TheAfricanJiant/epod/mobile/stitch_elite_interface_design (1)/stitch_elite_interface_design/device_status/code.html

settings_input_component

# e-Pod

sensors

## System Diagnostics

HW_REV_3.2 | MASTER_OF_RECYCLING

### BATTERY_HEALTH

80%

Donor: Modem X1

### sd_storage STORAGE_ALLOCATION

14.2 GB / 32 GB

Used

Free

### TELEMETRY_LOG

LIVE

[SYS] Init Sequence Complete 00:00:01

[NET] RSSI: -65dBm (Good) 00:00:04

[NET] MTU Size negotiated: 1500 00:00:05

[HW] Mic Array (ReSpeaker Lite) Ready 00:00:08

[SYS] Storage mount /dev/mmcblk0p1 OK 00:00:12

[WARN] Temp sensor 2 anomaly detected 00:00:15

[SYS] Awaiting command... 00:00:16

### VOICE_INPUT (ReSpeaker Lite)

Harvested 2-mic array for voice commands and localized processing.

mic Voice Control

### description LOCAL_VOICE_NOTES

- play_circle
  Idea_01.wav
  1.2 MB | 02:14
  delete
- play_circle
  Meeting_Notes.wav
  4.5 MB | 08:30
  delete

qr_code_scanner
