TheAfricanJiant/epod/mobile/stitch_elite_interface_design (1)/stitch_elite_interface_design/device_status_dark_soft/code.html

settings_input_antenna

# AudioPure

battery_charging_full

## Device Status

Real-time diagnostics and environmental telemetry for e-Pod unit alpha-7.

bolt

### Power Core

Healthy

80 %

Donor Module Tesla Mod-3 Cell

memory

### Storage

14.2 GB Used of 64 GB

Audio Data

System OS

Cache

record_voice_over

### Voice Interface

Wake Word "Hey e-Pod" activation

Continuous Listen Contextual follow-up mode

terminal

### Live Telemetry

Export Log

14:02:41.03 [SYS] Acoustic array initialized. 8/8 mics online.

14:02:41.15 [SYS] Thermal threshold nominal at 32°C.

14:02:42.88 [NET] Syncing metadata block xA92F... OK.

14:03:05.12 [BATT] Draw spike detected: 1.2A. Resuming normal envelope.

14:03:10.00 [SYS] Awaiting command stream...

14:03:10.01
