TheAfricanJiant/epod/mobile/stitch_elite_interface_design (1)/stitch_elite_interface_design/android_studio_template_guidance.md

# **Comprehensive Evaluation of Android Studio Project Templates and Development Specification for the e-Pod Companion Application**

## **Architectural Context and System Requirements**

The e-Pod zero-waste wireless audio player requires a companion Android mobile application to serve as an out-of-band management interface and binary file streaming client1. Operating within a 28-day build window, the system links a mobile handheld device directly to an ESP32-S3 microcontroller core (ReSpeaker Lite) integrated with an SPI MicroSD card module, an SSD1306 OLED display, an onboard 5W Class-D amplifier, and a salvaged laptop speaker1. Rather than utilizing traditional physical media connectors or cloud-mediated APIs, the system relies exclusively on Bluetooth Low Energy (BLE 5.0) for remote telemetry mirroring, media playback control, and chunked binary file transfer1.

\+---------------------------------------------------------------------------------------+  
|                                    Android Mobile App                                 |  
|                                                                                       |  
|  \+---------------------------------------------------------------------------------+  |  
|  |                           Presentation Layer (Compose UI)                       |  |  
|  |   \[Scan Screen\]    \[Now Playing Remote\]    \[File Transfer\]    \[Device Status\]   |  |  
|  \+---------------------------------------------------------------------------------+  |  
|                                          ^                                            |  
|                                          | (StateFlow / UI Events)                    |  
|                                          v                                            |  
|  \+---------------------------------------------------------------------------------+  |  
|  |                            Domain Layer (ViewModels)                            |  |  
|  \+---------------------------------------------------------------------------------+  |  
|                                          ^                                            |  
|                                          | (Suspend Functions / Flow)                 |  
|                                          v                                            |  
|  \+---------------------------------------------------------------------------------+  |  
|  |            BLE Transport Layer (Nordic Android-BLE-Library / ble-ktx)           |  |  
|  \+---------------------------------------------------------------------------------+  |  
\+------------------------------------------|--------------------------------------------+  
                                           |  
                                           | (BLE 5.0 GATT / MTU 517 Chunks)  
                                           v  
\+---------------------------------------------------------------------------------------+  
|                                  e-Pod Hardware Player                                |  
|                                                                                       |  
|  \+---------------------------------------------------------------------------------+  |  
|  |                  Core MCU: ReSpeaker Lite (XIAO ESP32-S3)                       |  |  
|  |                                                                                 |  |  
|  |   \+-------------------+     \+--------------------+     \+--------------------+   |  |  
|  |   | SPI MicroSD Card  |     | Onboard 5W Amp     |     | I2C SSD1306 OLED   |   |  |  
|  |   | (Audio Storage)   |     | & Laptop Speaker   |     | (Display UI)       |   |  |  
|  |   \+-------------------+     \+--------------------+     \+--------------------+   |  |  
|  \+---------------------------------------------------------------------------------+  |  
\+---------------------------------------------------------------------------------------+

Developing this application requires leveraging an AI pair-programming environment such as Antigravity1. Selecting an appropriate baseline template within Android Studio is essential to minimize architectural debt, eliminate unnecessary user interface boilerplate, and facilitate code generation1. The mobile client must implement Nordic Semiconductor’s Android-BLE-Library (specifically the modern ble-ktx coroutines module) to abstract Android’s native asynchronous Bluetooth Low Energy callbacks into reactive streams1.

## **Comparative Analysis of Android Studio Project Templates**

Modern Android Studio releases provide several starter templates designed for different application paradigms. Evaluating these templates against the operational requirements of the e-Pod client reveals significant trade-offs in structural complexity, UI framework alignment, and compatibility with AI-assisted code generation platforms1.

| Android Studio Template | UI Framework Architecture | Baseline Code Overhead | Suitability for e-Pod | Strategic Rationale and Technical Assessment |
| :---- | :---- | :---- | :---- | :---- |
| **Empty Activity** | Jetpack Compose (Material 3\) | Minimal | **Optimal (Recommended)** | Generates a clean, modern single-activity architecture configured for Jetpack Compose and ComponentActivity1. Eliminates legacy XML layouts, simplifying AI code generation while aligning natively with Kotlin StateFlow streams1. |
| **No Activity** | None (Raw Project Structure) | Zero UI Baseline | **High (Alternative)** | Configures Gradle scripts, dependency targets, and the manifest without generating UI components. Requires the AI workspace to construct the directory layout, DI modules, and activities from scratch. |
| **Empty Views Activity** | Legacy XML ViewBinding | Moderate | **Sub-optimal** | Configures legacy XML view hierarchies, ViewBinding classes, and AppCompatActivity. Adds layout boilerplate that increases friction when binding asynchronous BLE state streams1. |
| **Bottom Navigation Views Activity** | Legacy XML Views & Fragments | High | **Not Recommended** | Pre-configures a multi-fragment architecture using BottomNavigationView and NavController tied to XML resource graphs. Overcomplicates state synchronization across BLE connection lifecycles1. |
| **Navigation Drawer Views Activity** | Legacy XML Views & Drawer | High | **Not Recommended** | Designed for complex multi-tier enterprise applications utilizing drawer layouts. The e-Pod application requires a focused four-screen dashboard where persistent side drawers are redundant1. |
| **Native C++** | Android NDK / C++ CMake | Extremely High | **Unnecessary** | Configures CMake toolchains and Java Native Interface (JNI) stubs. Because hardware operations are executed on the ESP32-S3 microcontroller, native C++ compilation on the mobile client is redundant1. |

The evaluation demonstrates that the **Empty Activity** (Jetpack Compose) template represents the definitive structural foundation for the e-Pod mobile application1. Declarative UI frameworks natively observe asynchronous data streams emitted by Kotlin StateFlow primitives without requiring explicit view invalidation or adapter binding code2. Pre-configured templates utilizing XML layouts introduce legacy view management classes that complicate state propagation from background Bluetooth services3.  
By adopting the **Empty Activity** starter template, developers establish a lightweight structure that allows AI agents to output clean, single-activity Compose architectures without refactoring pre-generated layout files1.

## **BLE Protocol Architecture and Data Streaming Specification**

The mobile application operates as a GATT Central device communicating with the e-Pod peripheral hardware1. The custom primary GATT service configured on the ESP32-S3 exposes dedicated characteristics designed for remote control execution, hardware telemetry observation, and high-throughput binary file streaming1.

| Service / Characteristic Name | Assigned UUID | GATT Property Type | Data Frame & Protocol Payload |
| :---- | :---- | :---- | :---- |
| **e-Pod System Service** | 0000EPOD-0000-1000-8000-00805F9B34FB | Primary Service | Main service container for all e-Pod hardware features1. |
| **Remote Control Characteristic** | 0000EP01-0000-1000-8000-00805F9B34FB | Write Without Response | Single-byte command enumerations: 0x01 Play, 0x02 Pause, 0x03 Next Track, 0x04 Prev Track, 0x05 Vol Up, 0x06 Vol Down1. |
| **Device Telemetry Characteristic** | 0000EP02-0000-1000-8000-00805F9B34FB | Read / Notify | Structured byte array payload: Bytes 0–1: Track ID, Byte 2: Playback State, Byte 3: Battery %, Bytes 4–5: Free MicroSD Space (MB), Bytes 6+: Track Name (UTF-8)1. |
| **File Transfer Characteristic** | 0000EP03-0000-1000-8000-00805F9B34FB | Write Without Response | Sequenced binary chunk payload: Bytes 0–1: Sequence Index, Bytes 2–3: Data Length, Bytes 4+: Raw Audio Payload1. |

Streaming audio files over Bluetooth Low Energy without cloud infrastructure mandates maximizing transmission throughput1. Default BLE GATT transactions are constrained by a legacy ATT\_MTU size of 23 bytes, which yields a net application payload of only 20 bytes per transaction after subtracting standard 3-byte GATT headers.  
By invoking MTU negotiation via Nordic’s library immediately upon link establishment, the application requests an expanded ATT\_MTU of up to 517 bytes1. The maximum effective payload size per packet is defined by the formula:  
  
  
Negotiating connection intervals down to 15 milliseconds increases net data throughput from approximately 1.3 Kilobytes per second to over 30 Kilobytes per second1. This operational enhancement reduces file synchronization latency for standard audio files from minutes down to short operational windows, enabling efficient cable-free song transfers1.

## **Production-Ready Antigravity AI Prompting Specification**

To generate the mobile application architecture within the Antigravity workspace, the following system prompt must be supplied to the AI engine. The prompt encodes all operational parameters, runtime permission workflows, state structures, and UI layout requirements1.  
You are an expert Principal Android Mobility Engineer specializing in Kotlin, Jetpack Compose, Coroutines, StateFlow, and Bluetooth Low Energy (BLE) architecture.  
Your task is to develop the complete, production-ready companion Android application for "e-Pod" — a zero-waste wireless audio player powered by a Seeed ReSpeaker Lite (ESP32-S3) core running custom firmware.

### **1\. TECHNICAL STACK REQUIREMENTS**

* Primary Language: 100% Modern Kotlin  
* Minimum SDK: 26 (Android 8.0) | Target SDK: 34 (Android 14\)  
* UI Architecture: Single-Activity using Jetpack Compose with Material 3 Design  
* Async & State Management: Kotlin Coroutines, StateFlow, SharedFlow, ViewModel lifecycle models  
* BLE Protocol Library: Nordic Semiconductor's Android-BLE-Library (com.github.NordicSemiconductor:Android-BLE-Library:2.7.2) and ble-ktx extensions module (com.github.NordicSemiconductor:Android-BLE-Library:ble-ktx:2.7.2)  
* Architecture Pattern: MVVM with Repository Pattern and clean separation of concerns

### **2\. PERMISSIONS & ANDROID 12+ (API 31+) COMPLIANCE**

Implement a robust permission manager handling runtime checks.  
In AndroidManifest.xml:

* Declare android.permission.BLUETOOTH\_SCAN with android:usesPermissionFlags="neverForLocation"  
* Declare android.permission.BLUETOOTH\_CONNECT  
* Declare android.permission.BLUETOOTH\_ADVERTISE  
* Declare android.permission.READ\_EXTERNAL\_STORAGE (for API \< 33\) and android.permission.READ\_MEDIA\_AUDIO (for API 33+)

Implement logic in Jetpack Compose using RememberLauncherForActivityResult to request BLUETOOTH\_SCAN and BLUETOOTH\_CONNECT dynamically on application launch before scanning.

### **3\. BLE TRANSPORT & PROTOCOL SPECIFICATION**

Construct a dedicated BLE Manager class extending no.nordicsemi.android.ble.BleManager.  
GATT Protocol Configuration:

* Base Service UUID: "0000EPOD-0000-1000-8000-00805F9B34FB"  
* Control Characteristic UUID: "0000EP01-0000-1000-8000-00805F9B34FB" (Write Without Response)  
* Telemetry Characteristic UUID: "0000EP02-0000-1000-8000-00805F9B34FB" (Read \+ Notify)  
* File Sync Characteristic UUID: "0000EP03-0000-1000-8000-00805F9B34FB" (Write Without Response)

Connection Routine Requirements:

> 1. Implement isRequiredServiceSupported(gatt: BluetoothGatt) to validate all required characteristics exist.  
> 2. In initialize(), automatically request an expanded MTU by executing requestMtu(517).enqueue().  
> 3. Enable notifications on the Telemetry Characteristic. Parse incoming data packets:  
   * Byte 0-1: Track ID (UInt16)  
   * Byte 2: Playback State (0=Stopped, 1=Playing, 2=Paused)  
   * Byte 3: Battery Level (UInt8 0-100%)  
   * Byte 4-5: Available MicroSD Space in MB  
   * Bytes 6+: Track Name (UTF-8 String)  
> 4. Implement reliable connection handling: set retry(3, 100\) for connection establishment and handle drop events by emitting a Reconnecting state flow instead of crashing or hanging.

File Sync Protocol Implementation:

* Allow picking MP3/WAV files via Storage Access Framework (SAF) using ActivityResultContracts.GetContent().  
* Read file input stream and slice into chunks sized (Negotiated\_MTU \- 7\) bytes.  
* Prefix each outgoing packet with a 4-byte header: \[2 bytes Sequence Number (Big Endian)\] \+ \[2 bytes Chunk Length (Big Endian)\].  
* Stream chunks sequentially over the File Sync Characteristic using suspend functions, tracking transmission progress via a StateFlow\<Float\> progress indicator.

### **4\. SCREEN IMPLEMENTATION SPECIFICATIONS (JETPACK COMPOSE)**

Create a clean tabbed or bottom-navigation layout utilizing Material 3 Scaffold and NavigationBar exposing 4 screens:  
Screen 1: Scan & Connect Screen

* Displays status indicator (Disconnected, Scanning, Connecting, Connected).  
* FloatingActionButton / Button to trigger BLE scanning filtered by Service UUID 0000EPOD-0000-1000-8000-00805F9B34FB.  
* LazyColumn displaying scanned e-Pod devices showing device name, MAC address, and RSSI strength with a "Connect" button.

Screen 2: Now Playing / Remote Control Screen

* Centered track card displaying current song title mirrored from hardware telemetry.  
* Playback controls: Play, Pause, Next Track, Previous Track buttons triggering byte commands to the Control Characteristic (0x01=Play, 0x02=Pause, 0x03=Next, 0x04=Prev).  
* Volume slider sending volume scale values (0x05 \+ Vol Level) to the device.

Screen 3: Library & BLE File Transfer Screen

* File picker trigger to select audio files from device storage.  
* File metadata preview (File name, size in MB, estimated transfer time).  
* Transfer progress bar linked to StateFlow\<Float\> showing real-time upload status and speed.  
* Upload queue list showing completed and pending track transfers.

Screen 4: Device Status Screen

* Battery percentage display with visual battery status bar.  
* Storage health metrics: MicroSD total/used/free space rendered via dynamic progress graphics.  
* Hardware telemetry log: Displays connection RSSI, negotiated MTU size, and raw BLE service state details for debugging.

### **5\. CODE OUTPUT FORMAT REQUIREMENTS**

Provide full, clean, un-truncated Kotlin source code partitioned cleanly into logical files:

* MainActivity.kt  
* permissions/PermissionHandler.kt  
* ble/EPodBleManager.kt  
* ble/EPodProtocol.kt  
* viewmodels/EPodViewModel.kt  
* ui/screens/ScanScreen.kt  
* ui/screens/RemoteScreen.kt  
* ui/screens/TransferScreen.kt  
* ui/screens/StatusScreen.kt  
* ui/components/CommonUi.kt

Ensure all imports are explicitly stated, asynchronous workflows leverage Coroutine scopes correctly, and UI components handle connection states gracefully without freezing.

## **Implementation Schedule and Technical Risk Mitigation**

The development roadmap for the e-Pod companion application takes place between Day 12 and Day 17 of the overall project build plan1. The engineering tasks are structured to ensure software components align with hardware bring-up milestones1.

| Operational Timeline | Target Subsystem Module | Core Implementation Objectives | Verification Criteria |
| :---- | :---- | :---- | :---- |
| **Day 12** \[cite: 1\] | **Project Setup & BLE Scanner** | Initialize Android Studio project with Empty Activity. Configure runtime permissions for Android 12+1. Implement BLE device discovery routines1. | Scans and filters nearby e-Pod devices emitting the designated UUID1. |
| **Day 13** \[cite: 1\] | **GATT Connection & Control** | Implement EPodBleManager using Nordic ble-ktx coroutines3. Bind play, pause, next, and previous triggers to control characteristics1. | Phone buttons directly alter playback state on the physical ESP32-S3 hardware1. |
| **Day 14** \[cite: 1\] | **Telemetry Parsing Engine** | Subscribe to GATT telemetry notifications1. Parse track metadata, battery state, and available storage into reactive StateFlow models1. | App UI dynamically mirrors hardware SSD1306 OLED display text1. |
| **Day 15** \[cite: 1\] | **Chunked BLE Streaming** | Integrate Storage Access Framework (SAF) URI resolution1. Configure MTU 517 negotiation and chunked binary write streams1. | Audio files picked on the mobile device land on the MicroSD card and play back1. |
| **Day 16** \[cite: 1\] | **UI State Polish** | Refine Jetpack Compose dashboard views1. Add animated file transfer meters, battery bars, and storage capacity indicators1. | App provides a unified, responsive interface across all operational screens1. |
| **Day 17** \[cite: 1\] | **End-to-End Stress Validation** | Execute systematic connectivity, range, and stress tests across full scan-connect-transfer loops1. | Zero application crashes or GATT drops across 10 consecutive transfer cycles1. |

### **Addressing Android GATT Error 133 Exceptions**

A primary failure mode in native Android BLE development involves silent connection failures returning error code GATT 1334. This condition arises when connection attempts conflict with internal stack state caching or background radio activity6. Standard native Android API methods lack internal retry queues, causing immediate disconnection failures3.  
Nordic Semiconductor's library resolves this instability by embedding explicit connection retries and queue management directly into the connection pipeline3. Configuring connection requests with .retry(3, 100\) forces the execution stack to attempt three sequential re-connections at 100-millisecond backoff intervals before throwing an exception4. Additionally, disabling native background auto-connect parameters (useAutoConnect(false)) during active scanning prevents Android's internal GATT stack from stalling when pairing with hardware peripherals2.

### **Hardware Storage Contention and Streaming Controls**

Concurrent processing on the ESP32-S3 core introduces operational risks during file transfers1. If binary data streams over BLE outpace the microcontroller's SPI bus write speeds to the MicroSD card, incoming buffer overflows can cause frame corruption or trigger audio stuttering during real-time playback1.  
To mitigate hardware bus contention, the mobile application's streaming engine leverages explicit sequence headers combined with flow control1. By prepending packet chunk numbers to outgoing data payloads, the ESP32-S3 firmware validates frame integrity before committing data blocks to storage1. Incorporating micro-delays between packet bursts ensures continuous audio rendering alongside concurrent file writes, delivering a reliable wireless media streaming experience1.

## **Strategic Conclusions**

> 1. **Adopt the Empty Activity Starter Template**: Initializing the project using Jetpack Compose provides a clean slate without legacy XML layout overhead1. This design choice simplifies state binding and provides an ideal foundation for AI-assisted code generation in Antigravity1.  
> 2. **Leverage Nordic Semiconductor's BLE Infrastructure**: Integrating com.github.NordicSemiconductor:Android-BLE-Library (ble-ktx) abstracts native BLE callback complexities into clean Kotlin Coroutines and reactive StateFlow structures2. This architecture simplifies queueing, packet splitting, and MTU 517 throughput negotiation1.  
> 3. **Execute System Integration per the Schedule**: Adhering strictly to the Day 12–17 mobile application roadmap ensures that software streaming services, GATT controls, and telemetry views align with hardware milestones ahead of event-day demonstrations1.

#### **Works cited**

> 1. e-Pod\_Build\_and\_Launch\_Plan.pdf  
> 2. nordicsemi/Kotlin-BLE-Library \- GitHub, [https://github.com/nordicsemi/Kotlin-BLE-Library](https://github.com/nordicsemi/Kotlin-BLE-Library)  
> 3. nordicsemi/Android-BLE-Library \- GitHub, [https://github.com/nordicsemi/Android-BLE-Library](https://github.com/nordicsemi/Android-BLE-Library)  
> 4. Android-BLE-Library/USAGE.md at main \- GitHub, [https://github.com/NordicSemiconductor/Android-BLE-Library/blob/main/USAGE.md](https://github.com/NordicSemiconductor/Android-BLE-Library/blob/main/USAGE.md)  
> 5. Android Bluetooth Low Energy (BLE) Resources \- Gist \- GitHub, [https://gist.github.com/ajaypro/6a717d292cf892e1bfd733673d0581b5](https://gist.github.com/ajaypro/6a717d292cf892e1bfd733673d0581b5)  
> 6. Android Bluetooth Low Energy (BLE) Resources \- GitHub Gist, [https://gist.github.com/stkent/a7f0d6b868e805da326b112d60a9f59b](https://gist.github.com/stkent/a7f0d6b868e805da326b112d60a9f59b)

[image1]: <>

[image2]: <>
