TheAfricanJiant/epod/mobile/stitch_elite_interface_design (1)/stitch_elite_interface_design/music_library_dark_soft/code.html

settings_input_antenna

# AudioPure

battery_charging_full

## Ingest Media

wifi_tethering

Wi-Fi Transfer

usb

USB Import

cloud_sync

Cloud Sync

dns

NAS Connect

## Transfer Active

sync

04_Mahler_Symphony_No5.flac Receiving via Wi-Fi Direct

68%

42.5 MB / 185 MB 12.4 MB/s

## SD Card Content

98 GB / 512 GB Free

- audio_file
  Dark_Side_Master_24bit_96kHz.wav
  WAV 142 MB
  delete
- audio_file
  Miles_Davis_Kind_of_Blue.flac
  FLAC 95 MB
  delete
- audio_file
  Bicep_Isles_Album_Mix.flac
  FLAC 310 MB
  delete
- audio_file
  Nils_Frahm_Spaces_Live.wav
  WAV 850 MB
  delete

View All Files arrow_forward
