TheAfricanJiant/epod/mobile/stitch_elite_interface_design (1)/stitch_elite_interface_design/connect_dark_soft/screen.png

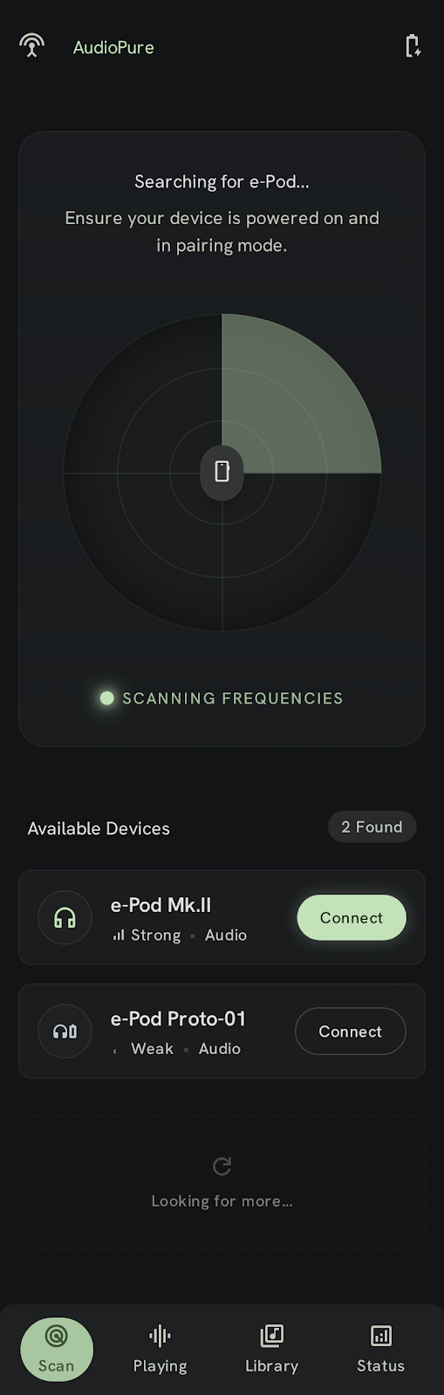
mobile/stitch_elite_interface_design (1)/stitch_elite_interface_design/connect_dark_soft/screen.png
