TheAfricanJiant/epod/mobile/stitch_elite_interface_design (1)/stitch_elite_interface_design/device_status/screen.png

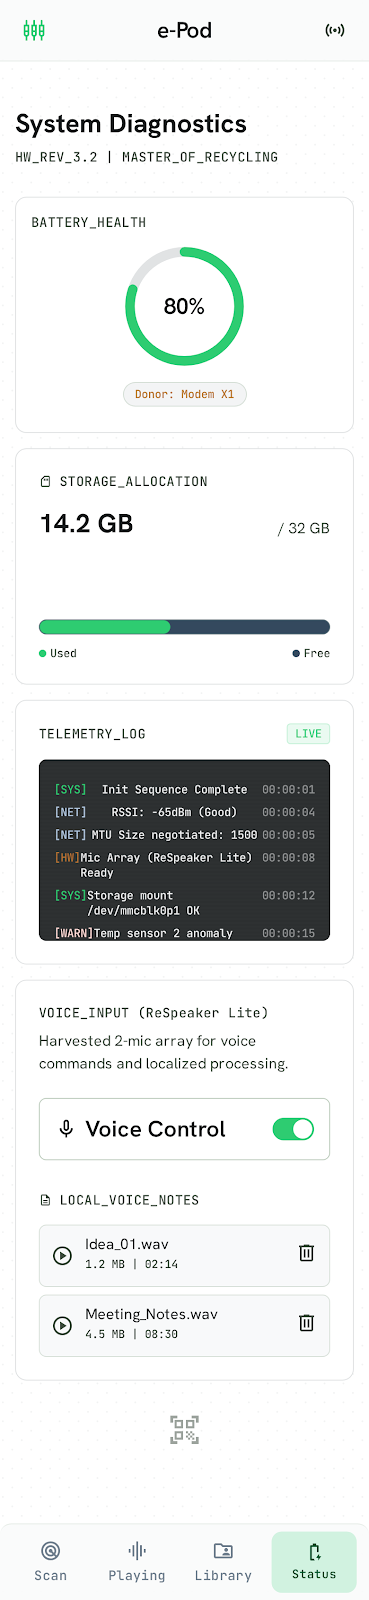
mobile/stitch_elite_interface_design (1)/stitch_elite_interface_design/device_status/screen.png
