TheAfricanJiant/epod/webapp/images/corn Fufu and vegitables.jpg

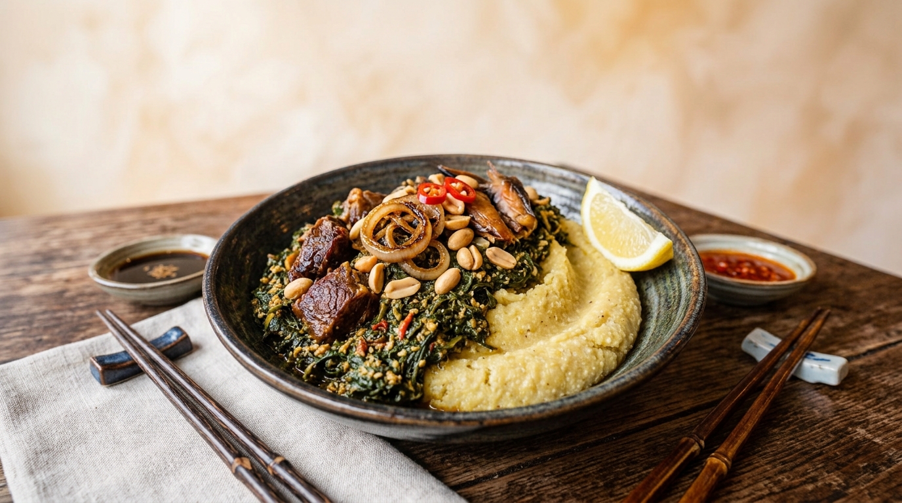
webapp/images/corn Fufu and vegitables.jpg
