TheAfricanJiant/epod/webapp/images/freid rice and chicken.jpg

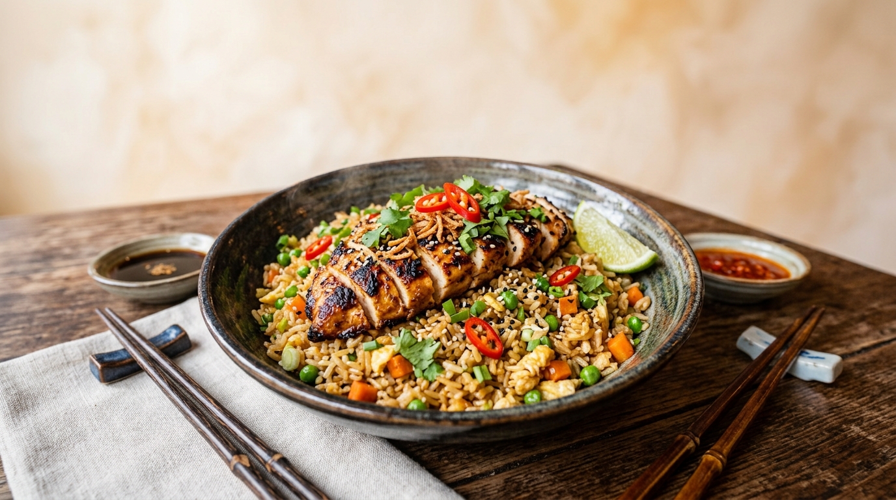
webapp/images/freid rice and chicken.jpg
