TheAfricanJiant/epod/webapp/images/salad.jpg

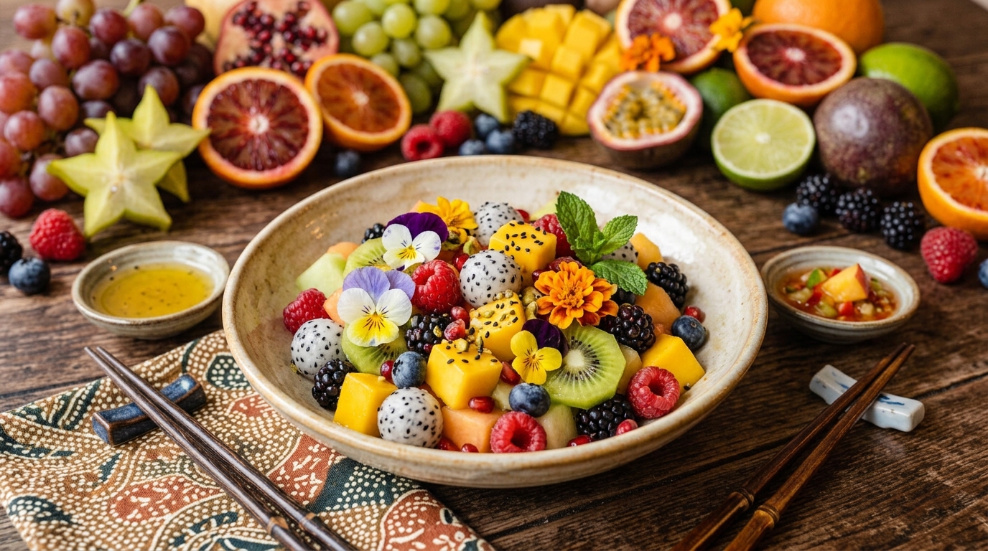
webapp/images/salad.jpg
