TheAfricanJiant/epod/webapp/images/salvory noodles.png

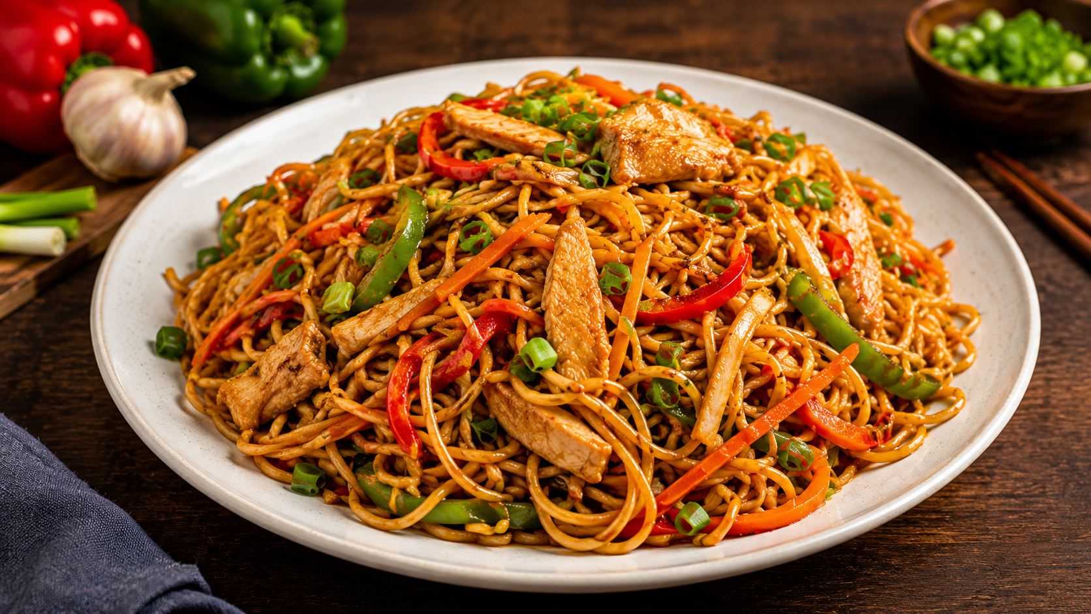
webapp/images/salvory noodles.png
