TheAfricanJiant/epod/webapp/images/water fufu and eru.png

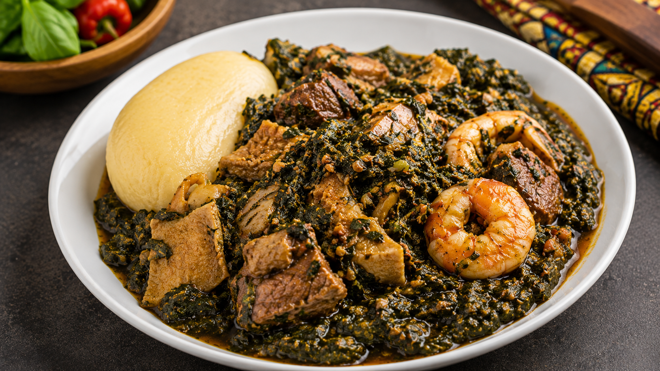
webapp/images/water fufu and eru.png
