TheAfricanJiant/epod/(commit log)

2026-09-01 Restructure as a monorepo: firmware, mobile app and signage web app
    Dual-MCU handheld player extended into an interactive restaurant menu
    driven by on-device machine learning.
    - firmware/xiao-esp32s3: voice keyword spotting, SD library, Wi-Fi
    Soft-AP and BLE, HTTP API for the signage page
    - firmware/esp32-wrover: OLED interface, buttons, audio playback
    - mobile: Android companion app
    - webapp: guest-facing menu with a self-running demonstration mode
    - docs/media: enclosure renders, wiring, build photos, app screens
    data_collection.ino moves under the firmware it captures training audio for.
2026-09-01 updates to the board spelling
