TheAfricanJiant/epod/docs/media/components-power-buttons.jpg

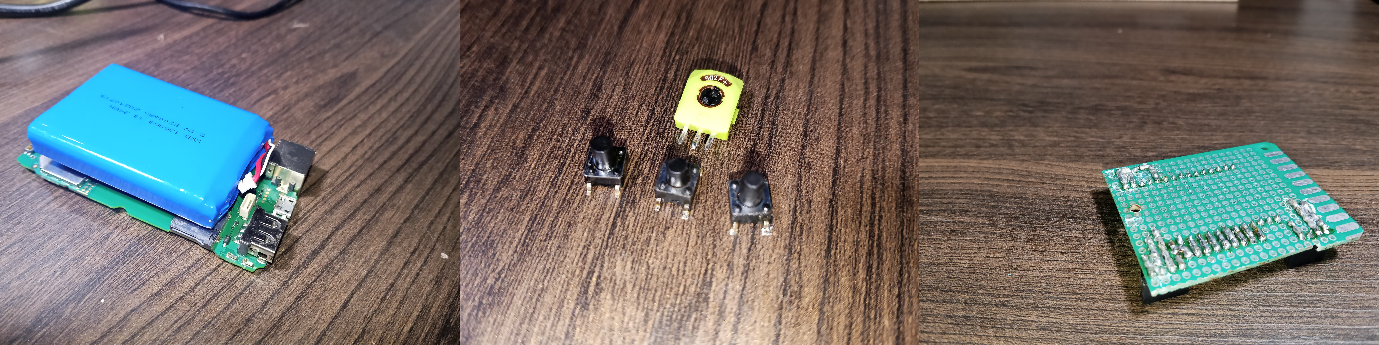
[picture p4: docs/media/components-power-buttons.jpg]
docs/media/components-power-buttons.jpg
